mars-college/mars-rover/README.md

RTSP player in HTML:  https://github.com/Streamedian/html5_rtsp_player

also useful maybe: use ffmpeg to change the container to HLS: https://stackoverflow.com/questions/1735933/streaming-via-rtsp-or-rtp-in-html5
also relevant: https://flashphoner.com/embedding-html5-rtsp-player-into-a-web-page/

#### Todo

- 360 cam local stream to dev environment
- stream over rtsp
- read rtsp into video canvas element
- send texture to aframe/WebXR
- view in cardboard or other VR environment
