mars-college/mars-rover/locomotion/README.md

# Locomotion: Activating the Body

Code and guide relating to making the Rover move.

## What's here

* Arduino - I2C based bridge between Jetson and Motor Drivers 
* Python - Mostly code for controlling motor drivers using Raspberry Pi PWM & direction logic output
* WebApp - A hacked together web based controller using websockets

## Alternatives

* [React native game pad (ios + android)](https://www.npmjs.com/package/react-native-game-pad) - upgrade the joystick
