mars-college/mars-rover/connectivity/README.md

# Connecting your Jetson Nano to the world

* [WiFi setup using the 8265AC card or the PAU05 dongle](wifi/README.md)
* [4GLTE using the SIM7600G-H hat](sim7600g-h/README.md)
* [Setting up a VPN with Wireguard](wireguard/README.md)
