mars-college/mars-rover/connectivity/wifi/README.md

# WiFi on the Jetson Nano

* [Setting up the 8265AC Adapter](8265ac/README.md)
	* Connect to existing network
	* Setup as WiFi Access Point
* [Setting up the PAU05 USB Adapter](pau05/README.md)
	* Connect to existing network
