mars-college/mars-rover/vision/flask/README.md

# Example of serving up PiCam in a web browser on JetsonNano using Flask

* Code lifted from: [Using Jetson Nano and a Raspberry Pi Camera for Video Streaming](https://maker.pro/nvidia-jetson/tutorial/streaming-real-time-video-from-rpi-camera-to-browser-on-jetson-nano-with-flask)

1. Install dependencies `$ sudo apt-get install python3-opencv python3-flask`
1. Run the server: `$ python3 server.py`
1. Open your browser and point it to: `http://<your_nano_IP>:8080`

* more nvidia GStreamer stuff [here](https://docs.nvidia.com/jetson/archives/l4t-archived/l4t-3231/index.html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)
