mars-college/mars-rover/vision/stabilization/research.md

# Make the 360 video stop shaking!

## Approaches

* realtime software stabilization (software)
* gimbal stabilazation (hardware)
* realtime remapping using accelerometer and gyroscope data (hybrid hardware-software)

## realtime software stabilization (software)

An approach that uses some form of realtime video tracking/camera solving and remapping/warping to achieve a stable image.

* [https://github.com/AdamSpannbauer/python_video_stab](https://github.com/AdamSpannbauer/python_video_stab)
* [https://github.com/georgmartius/vid.stab](https://github.com/georgmartius/vid.stab)
* [https://github.com/abhiTronix/vidgear](https://github.com/abhiTronix/vidgear)
	* from: [https://stackoverflow.com/questions/51970072/real-time-video-stabilization-opencv](https://stackoverflow.com/questions/51970072/real-time-video-stabilization-opencv)

### Pros

* no hardware necessary 
* free as in $0 (open-source FTW!)

### Cons

* introduces latency to video stream (processing overhead)

## gimbal stabilazation (hardware)

A mechanism that uses a gyro stabilized 3-axis motorized  system to smooth camera movement.

* [http://www.threesixtycameras.com/best-gimbals-for-360-cameras-stabilize-your-360-video/](http://www.threesixtycameras.com/best-gimbals-for-360-cameras-stabilize-your-360-video/)

### Pros

* possibly resolves gyro shakiness
* great for indoors, but why would you need one indoors anyways?

### Cons

* expensive $100+ for a decent gimbal
* may not resolve x/y/z accel shakiness
* have to find one that can hacked for control
* not suited for dusty, outdoor environments
* most are meant for hands to hold, not mounted on a rover.
* might require hacking the physical object

## realtime remapping using accelerometer and gyroscope data (hybrid hardware-software)

This is theoretical, but maybe something exists. The full software approach which basically has two components: analyze (produce motion vectors), deform-rotate (apply vectors to correct shakiness). Theoretically we should be able to replace the analysis with accelerometer and gyroscope data.

### Converting Dual-Fisheye to Equirectangular

* Fragment Shader That converts dual fisheye to equirectangular. Implements 3D rotational matrices to adjust roll, pitch and yaw: [https://github.com/yasuhirohoshino/oF-thetaEquirectangular](https://github.com/yasuhirohoshino/oF-thetaEquirectangular)
* Example of the basic theory of converting dual fisheye to equirectangular: [https://github.com/careyer/Insta360-Air-remap](https://github.com/careyer/Insta360-Air-remap)
* Simple example of "seamless" stitching: [http://paulbourke.net/dome/dualfish2sphere/](http://paulbourke.net/dome/dualfish2sphere/) 

### Rotation of Equirectangular Images

* 3D Rotation Matrices: [https://en.wikipedia.org/wiki/Rotation_matrix#In_three_dimensions](https://en.wikipedia.org/wiki/Rotation_matrix#In_three_dimensions)
* Equirectangular Rotation in C++ using OpenCV and the above: [https://github.com/whdlgp/Equirectangular_rotate/blob/master/Equirectangular_rotate.cpp](https://github.com/whdlgp/Equirectangular_rotate/blob/master/Equirectangular_rotate.cpp)

### Stabilization

* [https://engineering.fb.com/2016/08/31/ai-research/360-video-stabilization-a-new-algorithm-for-smoother-360-video-viewing/](https://engineering.fb.com/2016/08/31/ai-research/360-video-stabilization-a-new-algorithm-for-smoother-360-video-viewing/)
	* [Slightly more detail of above?](https://www.arducam.com/product/m32076m20-2/)
* [johanneskopf.de/publications/omnistab/360_video_stabilization.pdf](johanneskopf.de/publications/omnistab/360_video_stabilization.pdf)

### Sensors
* SparkFun Triple Axis Accelerometer and Gyro Breakout - MPU-6050: [https://www.sparkfun.com/products/11028](https://www.sparkfun.com/products/11028)
* [https://www.sparkfun.com/products/15335](https://www.sparkfun.com/products/15335)
* [https://www.sparkfun.com/products/13944](https://www.sparkfun.com/products/13944)
* [https://www.sparkfun.com/products/13284](https://www.sparkfun.com/products/13284)

### Pros

* Hardware without moving parts
* Should reduce processing overhead (skip analysis)
* Less expensive than pure hardware

### Cons

* Slightly more expensive
* We got to Frankenstein some shit together
* Still have to deal with hardware

## Additional Areas of Interest:

### Synchronized dual camera...

* If this works, well it's a dream. Truly too good to be true! [https://www.arducam.com/jetson-nano-one-arducam-driver-support-all-camera-sensor/](https://www.arducam.com/jetson-nano-one-arducam-driver-support-all-camera-sensor/)

### Dev Concerns
* Making it work in Oculus Quest (2)? [https://developer.oculus.com/documentation/oculus-browser/?locale=en_US&_fb_noscript=1](https://developer.oculus.com/documentation/oculus-browser/?locale=en_US&_fb_noscript=1)

### Rolling your own camera? J/K LOL... but maybe...

* IMX477 @ 220-260 degrees? Which is it? - [https://www.alibaba.com/product-detail/12MP-Wide-lens-220-260degree-fov_62363222813.html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](https://www.alibaba.com/product-detail/12MP-Wide-lens-220-260degree-fov_62363222813.html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)
* The M12 mount IMX477 - [https://www.arducam.com/product/arducam-high-quality-camera-for-jetson-nano-and-xavier-nx-12mp-m12-mount/](https://www.arducam.com/product/arducam-high-quality-camera-for-jetson-nano-and-xavier-nx-12mp-m12-mount/), [but it now...](https://www.uctronics.com/arducam-mini-high-quality-camera-with-m12-mount%20lens-b0251.html)
* And... a decent lens to put on top? 206 degrees if we're lucky... - [https://www.arducam.com/product/m32076m20-2/](https://www.arducam.com/product/m32076m20-2/)
* and the screw in mount if we want to modify others? - [https://www.uctronics.com/index.php/m12x-p05-small-camera-lens-plastic-mount-for-raspberry-pi-6mm.html](https://www.uctronics.com/index.php/m12x-p05-small-camera-lens-plastic-mount-for-raspberry-pi-6mm.html)
