mars-college/mars-rover/documentation/drone_vision.md

# Drone Vision

Telepresence on a MF drone!

## Leads

### Shops

https://www.amazon.com/stores/node/20595470011?_encoding=UTF8&field-lbr_brands_browse-bin=QWinOut

### Kits

https://www.amazon.com/QWinOut-Hexacopter-Unassembly-Controller-Kkmulticopter/dp/B00PRNMY2M?

### Controllers

https://seeeddoc.github.io/KKmulticontroller/res/KKmulticontroller_v5.5.pdf	

### DIY Guides

* https://dojofordrones.com/build-a-drone/
* https://dronenodes.com/how-to-build-a-drone/

## SDKs

* [Skydio](https://github.com/Skydio)
* Parrot
* [DJI](https://enterprise.dji.com/sdk?site=brandsite&from=nav)
	* [GitHub Repo](https://github.com/dji-sdk)
	* [Tello-Python](https://github.com/dji-sdk/Tello-Python) - This is a collection of python-based sample code that interact with the [Ryze Tello](https://www.ryzerobotics.com/tello) drone.
	* [Payload SDK](https://github.com/dji-sdk/Payload-SDK-Doc)
* Yuneec
