mars-college/mars-rover/documentation/research.md

# Telepresence Robot Brain Dump

Preliminary research on the current state of the art of telepresence robotics. Brainstorming things that we hope to achieve, features, concerns.

## Working definitions

A starting point for understanding the main terms and topics involved.

### Telepresence

> Telepresence refers to a set of technologies which allow a person to feel as if they were present, to give the appearance of being present, or to have an effect, via telerobotics, at a place other than their true location.
> 
> Telepresence requires that the users' senses be provided with such stimuli as to give the feeling of being in that other location. Additionally, users may be given the ability to affect the remote location. In this case, the user's position, movements, actions, voice, etc. may be sensed, transmitted and duplicated in the remote location to bring about this effect. Therefore information may be traveling in both directions between the user and the remote location.

-- [source: wikipedia](https://en.wikipedia.org/wiki/Telepresence)

### Telerobotics

> Telerobotics is the area of robotics concerned with the control of semi-autonomous robots from a distance, chiefly using Wireless network (like Wi-Fi, Bluetooth, the Deep Space Network, and similar) or tethered connections. It is a combination of two major subfields, teleoperation and telepresence.

-- [source: wikipedia](https://en.wikipedia.org/wiki/Telerobotics)

### Teleoperation

> Teleoperation (or remote operation) indicates operation of a system or machine at a distance...

-- [source: wikipedia](https://en.wikipedia.org/wiki/Teleoperation)

### Robotics

> Robotics is an interdisciplinary research area at the interface of computer science[1] and engineering. Robotics involves design, construction, operation, and use of robots.
 
-- [source: wikipedia](https://en.wikipedia.org/wiki/Robotics)

* [10 Robotics Companies You Should Know About](https://robots.net/robotics/robotics-companies/)

### Robots

> A robot is a machine—especially one programmable by a computer—capable of carrying out a complex series of actions automatically.[2] Robots can be guided by an external control device or the control may be embedded within.
> 
> Robots can be autonomous or semi-autonomous and range from humanoids such as Honda's Advanced Step in Innovative Mobility (ASIMO) and TOSY's TOSY Ping Pong Playing Robot (TOPIO) to industrial robots, medical operating robots, patient assist robots, dog therapy robots, collectively programmed swarm robots, UAV drones such as General Atomics MQ-1 Predator, and even microscopic nano robots.

-- ([source: wikipedia](https://en.wikipedia.org/wiki/Robot))

### Telepresence Robot

>“Technology that lets a human “inhabit” the body of a distant robot for remote exploration..."

-- Tom Simonite of NewScientist

>In the simplest form of an answer, a Telepresence Robot is basically a wheeled ‘Skype’ machine. 

>Also referred to as Virtual Presence Robots, Telepresence robot enables the user to extend their presence anywhere and anytime... to interact with the other party...

-- [source: robots.net](https://robots.net/tech-reviews/what-are-telepresence-robots-and-how-they-benefit-us/)

>A telepresence robot is a device that allows a remote user to dial into an audio/video conference and additionally allow them to drive the robot to various locations and look up/down, left/right to interact with other people and the environment in which the device is located.

>Telepresence robots allow you to be in remote locations without having to physically go there. It allows you to attend meetings or classes, visit family members in assisted living facilities or retirement homes, provide remote tech support or receptionist/hospitality services in various distant locations throughout the world all in the same day. Not only does it save a great deal of time and travel cost but it allows you to be where the telepresece [sic] robot is in an instant!

-- [source: MontaroBot](http://www.mantarobot.com/aboutus/faqs.htm#what-are-the-benefits-of-using-a-telepresence-robot)

## Example Applications

### Space

* Telescopes
* Satellites
* Rovers (Lunar and Martian)
* [ISS's Dextre](https://en.wikipedia.org/wiki/Dextre) - "Dextre, also known as the Special Purpose Dexterous Manipulator (SPDM), is a two armed robot, or telemanipulator, which is part of the Mobile Servicing System on the International Space Station (ISS), and does repairs otherwise requiring spacewalks.
* [Robonaut](https://en.wikipedia.org/wiki/Robonaut) - "A robonaut is a humanoid robot, part of a development project conducted by the Dexterous Robotics Laboratory at NASA's Lyndon B. Johnson Space Center (JSC) in Houston, Texas."
 
### Military
* [Boston Dynamics]()
* [GhostRobotics](https://www.ghostrobotics.io/about)

### Health

* Telemedicine

### Marine
### Home/Office
### Business/Commerce/Retail
### Education
* [Telepresent Graduations](https://www.timeslive.co.za/news/sci-tech/2020-04-07-watch-new-year-newme-avatar-robots-allow-students-to-attend-graduation/)

## Telepresence Robot Market

### Manufacturers

* [AMY Robotics](http://www.amyrobotics.com/indexen)
* [AXYN Robotique](https://www.axyn.fr/en/)
* [MantaroBot](https://www.mantarobot.com/)
* [Suitable Technologies](https://telepresencerobots.com/suitable-technologies)
* [Double Robotics](https://telepresencerobots.com/double-robotics)
* [VGo Communications](https://telepresencerobots.com/vgo-communications) (a subsidiary of [Vecna](https://www.vecnarobotics.com/))
* [Xandex](https://www.xandex.com/#xkubi) (took over production and sale of the Kubi from Revolve Robotics)
* [Anybots](https://telepresencerobots.com/anybots)
* [Collaborate i/o](https://telepresencerobots.com/robots/collaborate-io-robot)
* [SuperDroid Robots](https://telepresencerobots.com/superdroid-robots)
* [Adept MobileRobots](https://telepresencerobots.com/adept-mobilerobots)
* [Ava Robotics](https://telepresencerobots.com/irobot) (a subsidiary of [iRobot](https://www.irobot.com/))
* [Orbis Robotics](https://telepresencerobots.com/orbis-robotics)
* [Inbot Technology Ltd.](https://telepresencerobots.com/inbot-technology)
* [Endurance](https://telepresencerobots.com/robots/endurance-telepresence-robot)
* [Giraff Technologies](https://telepresencerobots.com/giraff-technologies)
* [Xaxxon Technologies](https://telepresencerobots.com/xaxxon-technologies)
* [Swivl](https://telepresencerobots.com/manufacturer/swivl)
* [R.Bot](https://telepresencerobots.com/manufacturer/rbot)
* [Wicron](https://telepresencerobots.com/wicron)
* [InTouch Health](https://telepresencerobots.com/intouch-health)
* [FutureRobot](https://telepresencerobots.com/futurerobot)
* [OhmniLabs](https://store.ohmnilabs.com/)
* [Ergotron](https://www.ergotron.com/en-us/) ([search results for telepresence](https://www.ergotron.com/en-us/search-results/s/telepresence))
* [Owl Labs](https://www.owllabs.com/)
* [Telexistence](https://tx-inc.com/en/home/) (possibly speculative)

#### List Sources:

* [telepresencerobots.com](https://telepresencerobots.com/manufacturers)
* [Best telepresence robots for business in 2020](https://www.zdnet.com/article/best-telepresence-robots/)

### Available Robots

A reference for telepresence robots available on the market as of 5/2020,lListed by brand.

#### Amy Robotics

At a Glance:

>Amy Robotics, funded in June 2015, is a high-tech innovation company specializing in R&D, manufacturing and sales of artificial intelligent robots. The headquarter is located in Hangzhou, China. R&D centers and overseas sales departments are also established in the United States and Germany, Japan and United Kingdom, respectively.

>Amy is committed to building world-class home and business service robots with cutting-edge technologies and revolutionary intelligent solutions.

>At present, Amy has its own independent technologies including bottom chassis driving, shock absorption, voice interaction, and noise reduction.

Notes:

* Not primarily in the market for telepresence solutions
* Autonomy is a higher priority over telepresence
* Mobility achieved via motorized wheel system

Models:

* AMY-M2-D Sterilizing Robot
* [AMY-M2-W ANGEEI UVC Sterilizing Robot](http://www.amyrobotics.com/indexpdetailsen?id=21)
	* Autonomous operation and charging
* [AMY-M1C Service Robot](http://www.amyrobotics.com/indexpdetailsen?id=5)
	* Autonomous Navigation
	* Responds to Voice Commands
	* Application in security monitoring / surveillance
	* Telepresence capable (via 4G)
	* Automatic docking and recharging 
* [AMY-A2 Service Robot](http://www.amyrobotics.com/indexpdetailsen?id=6)
	* Similar features to AMY-M1C

#### AXYN Robotique

At a Glance:

>AXYN Robotique...designs, manufactures and markets service robots...

>"To be here and elsewhere at the same time." The range of Ubbo telepresence robots offers mobility, autonomy and adaptability to each sector of activity. It delivers the power of ubiquity to each user. 

>Thanks to Ubbo, you can interact and be present with your loved ones, your collaborators, in any circumstance, wherever you are.

Notes:

* Focused on telepresence.
* Offers 3 models: 2 different mobile telepresence robots and 1 tabletop teleconferencing solution.
* Focused on [business](https://www.axyn.fr/en/business/), [education](https://www.axyn.fr/en/education/), and [senior care](https://www.axyn.fr/en/senior-care/)

Models:

* [Ubbo Expert](https://www.axyn.fr/en/ubbo-expert/)
	* 13.3in Screen
	* WiFi & 4G connectivity
	* API on request
	* Wheel based mobility
	* Head tilt and pan
	* OpenTok + WebRTC technology
* [Ubbo Maker](https://www.axyn.fr/en/ubbo-maker/)
	* For use with Android tablets
	* open source - available in kit or complete
	* 4 "mecanum" wheels allowing transverse movements 
	* obstacle sensors
	* WiFi & 4G connectivity
	* OpenTok + WebRTC technology
* [Ubbo Spot](https://www.axyn.fr/en/ubbo-spot/) (available soon)
	* All in 1 Tabletop solution
	* Pan & Tilt controls
	* WiFi & 4G connectivity

#### Kubi

At a Glance:

>The Kubi telepresence robot is manufactured by Xandex Inc. in Petaluma, California.

>In May, 2017 when Revolve Robotics wound down operations and closed its doors, Xandex assumed all sales and support actitivities for Kubi products.

>Xandex completed the acquisition of Revolve Robotics assets and intellectual property in January, 2019.

-- [source](https://kubiconnect.com/about.html)

Notes:

* Primarily table-top solutions for converting a tablet into a telepresence device
* Telepresent user can control tilt and swivel of the stand.
* App required for control
* Use with any

Models:

* [Kubi Classic](https://kubiconnect.com/e-commerce/kubi-classic.html)
	* low cost, portable
	* accommodates 7-10 inch tablets.
	* gives the remote user the ability to look around the room and be part of the conversation.
	* BYO teleconferencing software and the Kubi Control app for Android or Apple tablets.
* [Kubi Plus](https://kubiconnect.com/e-commerce/kubi-plus.html)
	* accommodates 10-13 inch tablets.

#### Mantaro

At a Glance:

>MantaroBot is a division of Mantaro a product development and services company located in Germantown Maryland... Mantaro was established in 2001 and launched the MantaroBot line of products in 2010.  The MantaroBot products are designed and manufactured by Mantaro.

News:

* [Mantaro launches ‘rugged’ telepresence robot for industrial settings](https://roboticsandautomationnews.com/2016/09/05/mantaro-launches-rugged-telepresence-robot-for-industrial-settings/7006/)

Notes:

* Small but diverse line of products
* Custom Robot Design Service
* Manufacturing Service
* Have a web-based control solution, [TeleGo](http://www.mantarobot.com/telego/)

Models:

* [TeleMe 2](http://www.mantarobot.com/products/teleme-2/index.htm)
	* Robotic tablet stand
	* Use with any AV conferencing software
	* Pan-tilt control
	* Remote controlled movement
* [TableTop TeleMe](http://www.mantarobot.com/products/tabletop_teleme/index.htm)
	* same features as TeleMe 2 but in a stationary, tabletop design.
* [TeleTrak](http://www.mantarobot.com/index.php?option=com_content&Itemid=304&id=108&lang=en&layout=edit&view=article)
	* [Head](http://www.mantarobot.com/products/teletrak/head.htm) designed for Microsoft Surface Pro 4 features speakers, headlights, aimable laser, pan-tilt control
	* [Arm](http://www.mantarobot.com/products/teletrak/arm.htm) features a close-up camera, extendable finger, line-laser, raise-lower + left-right motion control
	* [Base](http://www.mantarobot.com/products/teletrak/track-base.htm) features 3x articulated track per side for traversing variegated terrain, headlights, sensor, emergency shutoff, stop before fall. 
* [TeleTrak LE](http://www.mantarobot.com/index.php?option=com_content&Itemid=361&id=117&lang=en&layout=edit&view=article)
	* Track base
	* Pan-tilt control surveillance cam
	* RF local control
	* WiFi + 4G control
	* Real-time communication

## What do we hope to achieve?

* The ability for people to "teleport" or be virtually transported to different geographic (and potentially virtual spaces).
* A more seamless experience for self-guided exploration than afforded by conventional pan-tilt systems
* To enable people to have agentive power in remote locations of their choosing.
* To extend the act of communication into an embodied form over distances.
* Giving people the ability to access and have some form of encounter with circumstances and locations that are drastically different or opposed to their own.
* To improve collaborative work over distances by providing a sense of physical presence between team members.

## Affordances

* Vision
* Hearing
* Speech/Voice
* Mobility
* Limbs
	* pointing
	* influencing environment
	* manipulating objects
	* gestural communication
	* self defense?
* Dexterity

### Vision

* Dual 360 (possibly 180) degree camera system that enables stereoscopic, VR view of the telepresence robot's location.
* IR sensors for object detection
* CV for scene analysis and input to motion systems

### Hearing

* Ambisonic microphone array in order to facilitate an accurate spatial reconstruction of the telepresence robot's sonic environment.

### Voice/Speech

* Most communication will occur with a human "inhabiting" the robot.

## Privacy Concerns
* Unwanted spying or eavesdropping
	* Live Camera Indicator (connected to device power)
	* Live Mic Indicator (connected to device power)
	* Video Mute switch/command
	* Audio Mute switch/command
* Mobility into restricted or private areas
	* Establish privileged spatial access
	* "Paralyze" robot command
	* "Kill" remote access command

## Security Concerns

* Access Control
* Encrypted Connections
* Theft of Robot
* Physical Access to Ports
* Physical Access to Hardware
* Securing default settings
	* Zero access by default
	* Users must be credentialed
* Privileged feature access

--

# Identity

A brainstorm of names and possible mascot/logo ideas

## What's in a name?

Potential Names for the Project and/or Bot(s)

* Mars Rover
* Shell
* GhostShell
* Red Rover
* Teleporter
* Wormhole
* Mask
* Spirit Home
* Temple
* Shrine
* Enshrined
* Inhabit
* Habitat

--

# Technology

--

# Hardware

## Robotics Supply Retailers

* [SuperDroid Robots](https://www.superdroidrobots.com/shop/category.aspx/treads-and-tracks/55/)
* [Pololu](https://www.pololu.com/)
