mars-college/mars-rover/locomotion/WebApp/JetsonNano/images/rover-on-mars.jpg

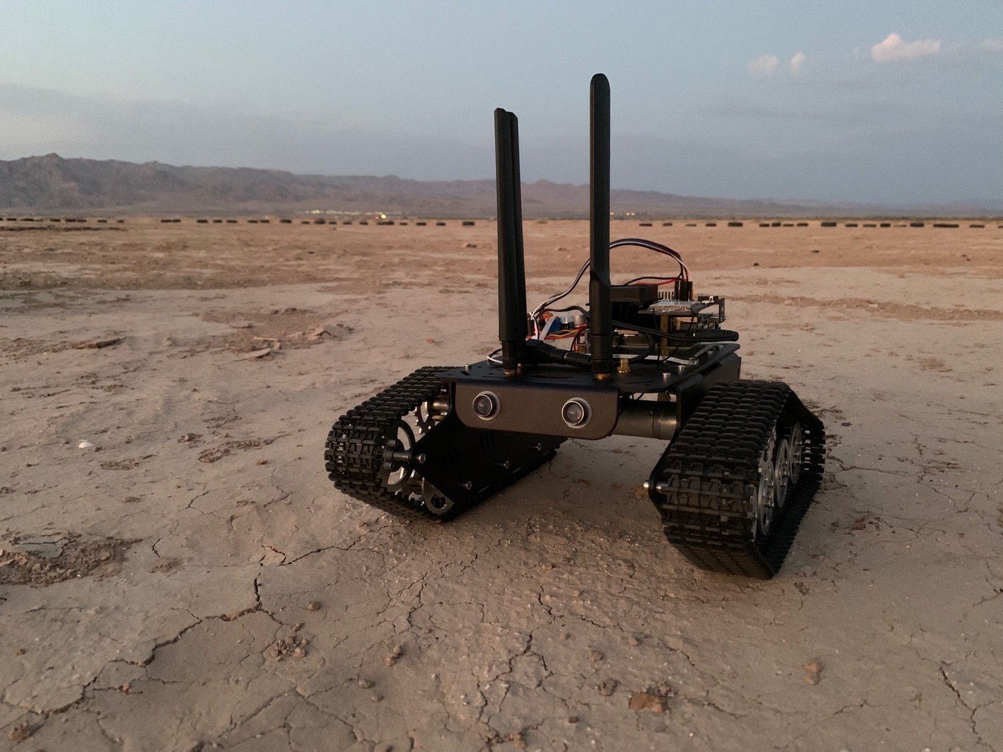
locomotion/WebApp/JetsonNano/images/rover-on-mars.jpg
