mars-college/mars-rover/locomotion/WebApp/JetsonNano/images/rover_02-2413.jpg

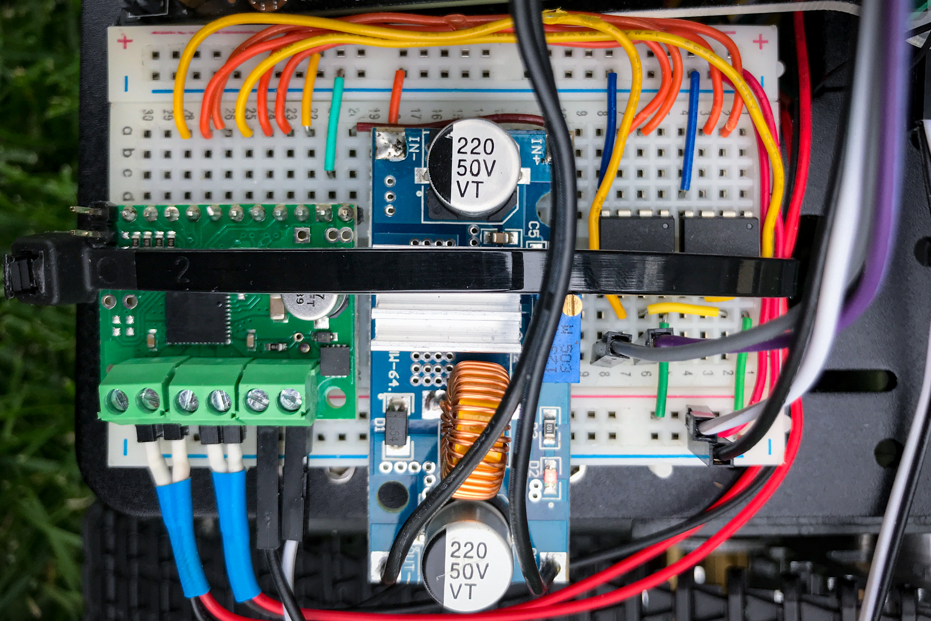
locomotion/WebApp/JetsonNano/images/rover_02-2413.jpg
