mars-college/mars-rover/www/images/Screen Shot 2020-06-09 at 6.14.26 PM.png

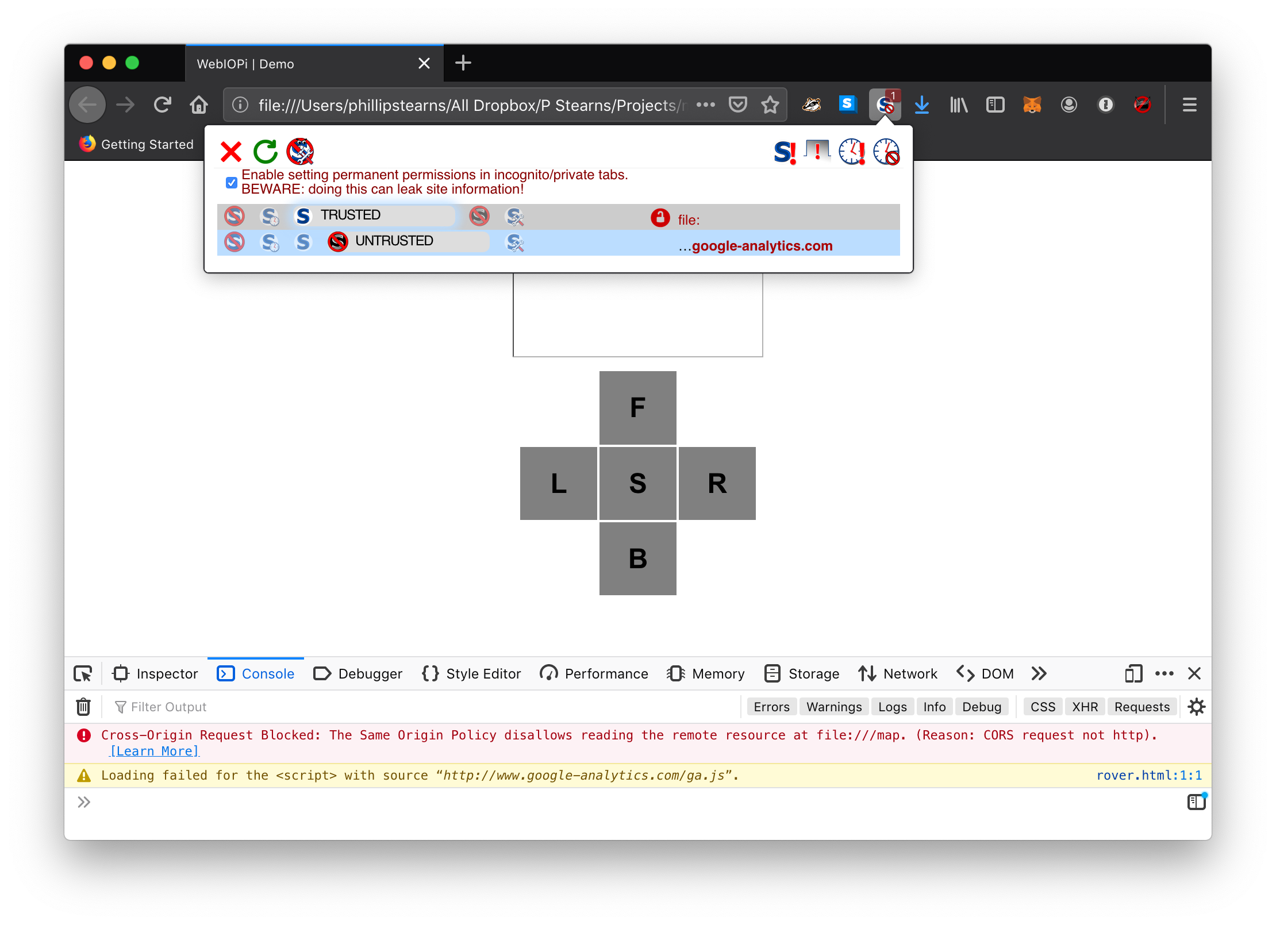
www/images/Screen Shot 2020-06-09 at 6.14.26 PM.png
