mars-college/mars-rover/documentation/Parts.md

# Resources

A tracker for parts ordered and sources

## Parts Ordered:

Let's keep things organized by individuals:

* Gene
* Sophia
* Phil

## Gene's Parts

* Jetson Nano
* Ricoh Theta S
* MPU9250
* BNO055

## Sophia's Parts

no spider bots yet...

## Phil's Parts

### NVIDIA Jetson Nano Developer Kit vB01

* [NVIDIA Jetson Nano Developer Kit (945-13450-0000-100)](https://www.amazon.com/gp/product/B084DSDDLT/)

### Makeronics Jetson Nano 8265AC/8265NGW Wireless NIC Module

* [Makeronics Jetson Nano 8265AC/8265NGW Wireless NIC Module M.2 NGFF Support 2.4GHz / 5GHz 300Mbps / 867Mbps Dual Band WiFi and Bluetooth 4.2](https://www.amazon.com/gp/product/B07X2NLL85/)

### Tank Robot Platform

Notes: Kit for assembly takes about 2 hours to complete. Seems pretty solid.

* [MOUNTAIN_ARK Tracked Robot Smart Car Platform Metal Aluminium Alloy Tank Chassis with Powerful Dual DC 9V Motor for Arduino Raspberry Pi DIY STEM Education Easy Assembly, 11.0x9.8x4.5inch, 3Lb](https://www.amazon.com/gp/product/B07JPL6MHR/)

### 18650 Lithim-Ion Batteries

* [liogea Protected 3.7V LG3400G 3400mAh 10A Rechargeable Button Top Batteries for Fan Spotlight Flashlight - 2 Pack](https://www.amazon.com/gp/product/B07YBTQSQL/)
* 8x [LG MH1 INR 18650 3200mAh 3.6V 10A Unprotected Lithium Manganese Nickel (LiNiMnCoO2) Flat Top Battery](https://www.batteryjunction.com/lg-mh1-18650-3200mah-battery.html)

### Battery Holders

* [4 pcs Battery Holder,SACKORANGE 18650 Battery Storage Case Plastic Box Holder Leads with 4 Slots for 6" Wire Leads](https://www.amazon.com/gp/product/B06XSHT9HC/)

### Battery Chargers

* [18650 Battery Charger, FARSAIL Rechargeable Battery Charger Compatible with 3.7V Lithium ion 18650 18350 18500 RCR123A 18490 17670 17500 and NiMH/NiCd AA AAA Rechargeable Batteries](https://www.amazon.com/gp/product/B077VVNYLY/)
* [USB C 21700 Battery Charger XTAR VC8 Type C 3A Fast 18650 Charger 8-Bay Smart Charger with Automatic LCD Display for 3.6V 3.7V Li-ion 10440 16340 18700 26650 1.2V Ni-MH AA AAA C](https://www.amazon.com/gp/product/B07ZSHFFHF/)
* [LiPo Battery Charger 1S-6S Balance Discharger Digital Battery Pack Charger for NiMH/NiCD/Li-Fe Packs w/LCD Display Hobby Battery Chargers w/Tamiya/JST/EC3/HiTec/Deans Connectors + Power Supply ](https://www.amazon.com/gp/product/B07P71CKFW/)

### Battery Management System / Protection

* [Anmbest Enhanced 3S 11.1V/12V/12.6V 40A 18650 Charger PCB BMS Protection Board Li-ion Lithium Battery Charger Lipo Cell Module for Drill Motor 12.6V](https://www.amazon.com/gp/product/B07RPW8MM6/)

### Motor driver boards

* 2x [Adafruit TB6612 1.2A DC/Stepper Motor Driver Breakout Board](https://www.amazon.com/gp/product/B00VY32VU4/) - note: limited amperage is a problem
* 2x [TB67H420FTG Dual/Single Motor Driver Carrier](https://www.pololu.com/product/2999)

### 5V DC Regulators/Converters

* [eBoot 12 Pack Mini MP1584EN DC-DC Buck Converter Adjustable Power Step Down Module 24V to 12V 9V 5V 3V (12 Pack)](https://www.amazon.com/gp/product/B01MQGMOKI/)
* 2x [Pololu 5V, 5A Step-Down Voltage Regulator D24V50F5](https://www.pololu.com/product/2851)

### Jetson Nano B01

Notes: Selected over A2 because the B0 has 2x PiCam connections

* [NVIDIA Jetson Nano Developer Kit (B01)](https://www.amazon.com/gp/product/B084DSDDLT/)

### Open-frame case for Jetson Nano B0

Notes: fan is a pain to install

* [GeeekPi Jetson Nano Case (Support Jetson Nano B01 and A02 Version), Jetson Nano Case with Fan...](https://www.amazon.com/gp/product/B07SXJHQD1/)

### 5v 4A power supply

* [SMAKN DC 5V/4A 20W Switching Power Supply Adapter 100-240 Ac(US)](https://www.amazon.com/gp/product/B01N4HYWAM/)

### 2x Wide Angle Lens for Jetson Nano

* [SainSmart IMX219 Camera Module for NVIDIA Jetson Nano Board & Raspberry PI CM3 8MP Sensor 200 Degree FoV ](https://www.amazon.com/SainSmart-IMX219-Camera-Module-Raspberry/dp/B07WR87J2W/)

Resources:

* [Jetson Nano + Raspberry Pi Camera](https://www.jetsonhacks.com/2019/04/02/jetson-nano-raspberry-pi-camera/)
* [Jetson Nano B01 - Dual RPi Cameras + how to get faster frame rates](https://www.youtube.com/watch?v=GQ3drRllX3I)

### 2x PiCam360

* [PICAM360-CAMPT8MP](https://store.picam360.com/#!/PICAM360-CAMPT8MP/p/87584243/category=0)

### 4G Module

* [waveshare SIM7600G-H 4G/3G/2G/GNSS Expansion Board for Jetson Nano Supports LTE CAT4 up to 150Mbps Global Applicable for GPS, BeiDou, Glonass, LBS Base Station Positioning](https://www.amazon.com/gp/product/B085MJD742/)

### 4GLTE SIM

* [Mint](https://www.mintmobile.com) - $45 introductory offer for 3mos of 3GB/mo 4GLTE data
	* Considering Purchasing the top level plan for a year once we have video streaming leveled up.

### ATTiny85

* 2x [ATTiny85](https://www.mouser.com/productdetail/microchip-technology-atmel/attiny85-20pu?qs=8jWQYweyg6NCiiaOb5GI9Q%3D%3D)

### Arduino Nano Clone

* 1x [Mini Nano V3.0 ATmega328P Microcontroller Board with USB Cable for Arduino](https://www.amazon.com/FTCBlock-ATmega328P-Microcontroller-Board-Arduino/dp/B07H31FS8J/)

### Accelerometer & Gyroscope Modules

* 1x [HiLetgo 3pcs GY-521 MPU-6050 MPU6050 3 Axis Accelerometer Gyroscope Module 6 DOF 6-axis Accelerometer Gyroscope Sensor Module 16 Bit AD Converter Data Output IIC I2C for Arduino](https://www.amazon.com/gp/product/)

### Game Controllers

* 1x [DarkWalker Wireless Bluetooth Controller, Mobile Controller for iOS 13 or Later Support MFI-Compatible Games - Android 10 Cloud Gaming Support Xcloud Stadia Shadow - PS4](https://www.amazon.com/gp/product/B088KF3Z9R/)

### USB Audio Interface

### 2x Stereo to Dual-Mono Y splitter

### 2x Audio Cables
