mars-college/mars-rover/(commit log)

2020-01-01 Cameras.md changes
2020-06-01 added JetsonNano setup guide
2020-06-02 add of camera processor
2020-06-04 update texture from camera
2020-06-04 dual-fisheye to equirectangular shader, easy peasy 🎉
2020-06-06 JetsonNano PWM hell
    [NV_Jetson_Nano_Module_Pinmux_Config_Template.xlsm, jetson_nano_sd.csv]
2020-06-09 future wiki
    [NV_Jetson_Nano_Module_Pinmux_Config_Template.xlsm, jetson_nano_sd.csv]
2020-06-17 renamed wiki to documentation
    [NV_Jetson_Nano_Module_Pinmux_Config_Template.xlsm, jetson_nano_sd.csv]
2020-06-18 Arduino code for PWM over I2C. Yipee!
2020-06-19 wrestling with I2C on ATTiny85, Jetson Nano
2020-06-23 installtion and setup guide for AC8265-Wireless-NIC-Module
2020-06-23 ATTiny85 and Jetson Nano server fixes
    [i2c-test.py, i2c_Slave.ino, server-test-local.py, server.py]
2020-07-01 incremental updates to Nano wireguard guide
2020-07-02 making incremental updates to the JetsonNano guide in the WebApp section
2020-07-02 removed unnecessary documents from documentation
    [NV_Jetson_Nano_Module_Pinmux_Config_Template.xlsm, jetson_nano_sd.csv]
2020-07-05 Draft of Jetson Nano Guide in WebApp
2020-07-08 finally got the code in line with the wiring #nailedit
2020-07-16 tightening simcom_wwan@.service scripts
2020-07-17 added image to Jetson WebApp docs
2020-08-20 renaming wireguard guide to match convention
2020-08-29 zero power to motors on socket close
2020-09-02 kill motors when connection is closed
2020-11-19 roll your own camera and more docs to 360 jitters
    [server.py]
2020-11-27 yaw, pitch, roll parameters added to shader
2020-11-28 Revisiting Locomotion Code, making I2C mo betta
2020-11-30 Making progress on gyro
2020-12-14 Making progress on the gyro
2020-12-25 tweaking motor control
2021-01-27 untested changes to ws-client.js, tiny cleanup of arduino i2c code
2021-01-27 untested changes to ws-client.js, tiny cleanup of arduino i2c code, minor cleanup and commenting on server.py
2021-02-02 First Commit Of Squinard Cut
    This represents the squinard cut. It is faster and more bare metal. A small list of changes:
    More reliance on gstreamer
    Websockets
    Ditched CV2
    Ditched aFrame (temporary)
    And a few more things.
2021-02-09 Working Websocket Branch
    First fully working commit, with no memory leak!
    [server.py]
